hermes-motors/fengari/materials.org

* Supplied
+ [X] 1x 1P52FMI engine (including intake, carburetor, shifter, kickstarter, CDI)
+ [X] 1x 1P52FMI exhaust
+ [X] 2x 415H chain - 11.8872mm overall width, 4.75mm inner width
+ [X] 1x M8 Foot pegs
+ [X] 1x keyshaft 15mm (diameter) x 50mm (length)
+ [X] 1x key 5mm x 5mm x 35mm
+ [X] 2x 6902-2RS Bearing 15mm ID, 28mm OD, 7mm W
+ [X] 5x M8 threaded rod x 300mm (cut down to 180mm) (engine mount)
+ [X] 11x M8 nuts
+ [X] 15x M8 washers
+ [X] 1x M8 x 10mm (exhaust mount)
+ [X] 4x M6 x 35mm (sprocket)
+ [X] 4x M6 x 15mm (electrical enclosure)
+ [X] 6x M2 x 16mm (bearing retainer)
+ [X] 6x M2 nuts (bearing retainer)

* Machined
+ [X] 2x 3.175mm flat face mounts
+ [X] 1x 3.175mm support brace
+ [X] 2x 3.175mm jackshaft mount
+ [X] 4x 1.88mm jackshaft bearing retainer
+ [ ] 1x 3.175mm exhaust mount
+ [ ] 1x 1.88mm jackshaft bearing cap
+ [ ] 1x jackshaft sprocket
+ [ ] 1x engine sprocket
+ [X] 1x 4.75mm shift relocater
+ [ ] 1x 4.75mm chain tensioner

* Printed
+ [X] 1x electrical enclosure

* Spacers
15mm OD, 8mm ID

+ [X] 1x 5mm exhaust hanger spacer
+ [X] 1x 10mm engine mount offset spacer
+ [X] 5x 40.0mm jackshaft spacers
+ [X] 3x 31.0mm right side engine mount spacers
+ [X] 3x 12.5mm pre-jackshaft spacers
+ [X] 3x 56mm inner frame spacers
+ [X] 2x 15.5mm engine mount to jackshaft mount spacers

* Complete
+ [ ] Wiring Harness
