hermes-motors/fengari/dxf/jackshaft_mount_4.dxf

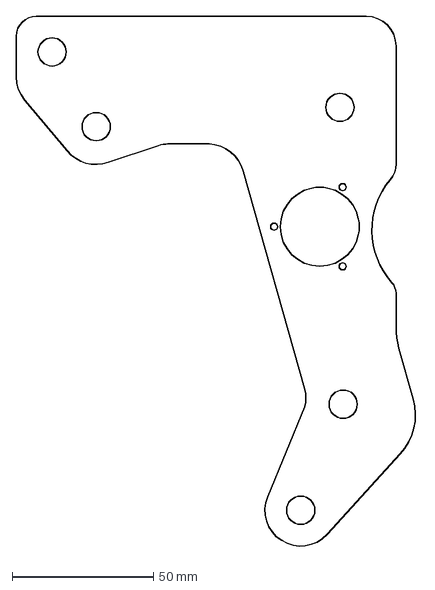
[picture p1: CAD file, 2023-04-24]
dxf/jackshaft_mount_4.dxf
142.5 x 189.0 mm
