hermes-motors/fengari/electric_enclosure.FCStd

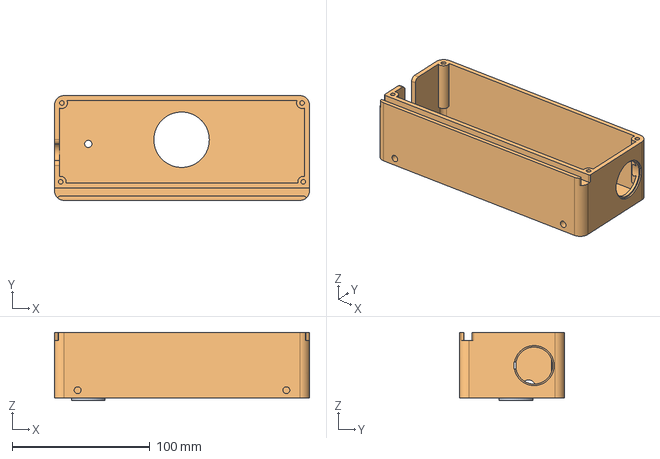
[picture p2: CAD file, 2026-04-15]
electric_enclosure.FCStd
185.0 x 76.0 x 49.5 mm
Spacer
Enclosure002
