hermes-motors/fengari/stl/shift_relocate-Extrude.stl

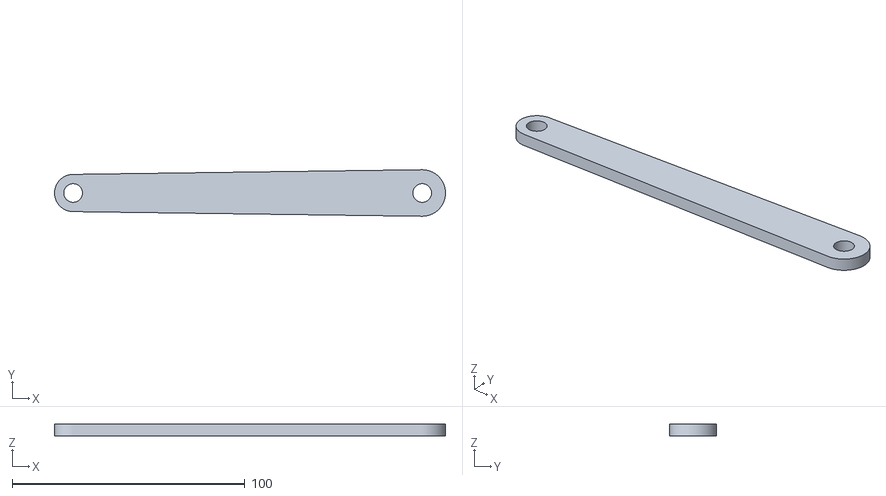
[picture p3: CAD file, 2023-12-20]
stl/shift_relocate-Extrude.stl
168.0 x 20.0 x 5.00
