hermes-motors/fengari/dxf/jackshaft_bearing_retainer.dxf

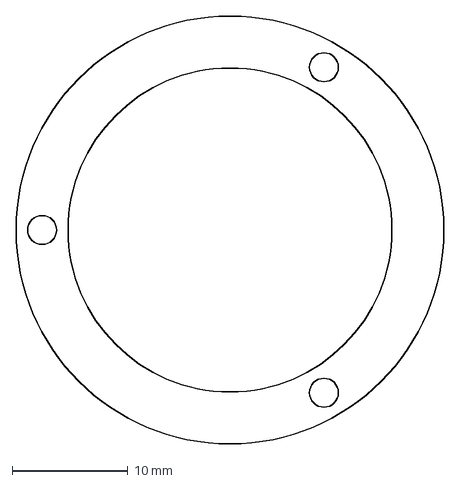
[picture p4: CAD file, 2023-04-24]
dxf/jackshaft_bearing_retainer.dxf
36.9 x 36.9 mm
