hermes-motors/fengari/engine_sprocket.FCStd

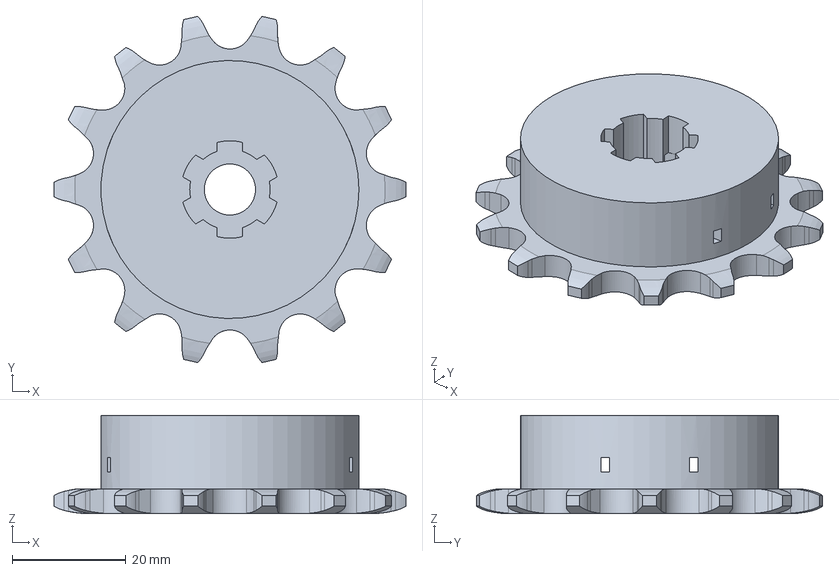
[picture p5: CAD file, 2026-04-10]
engine_sprocket.FCStd
61.9 x 60.9 x 17.3 mm
