hermes-motors/fengari/stl/jackshaft-Jackshaft Sprocket Spacer 2.stl

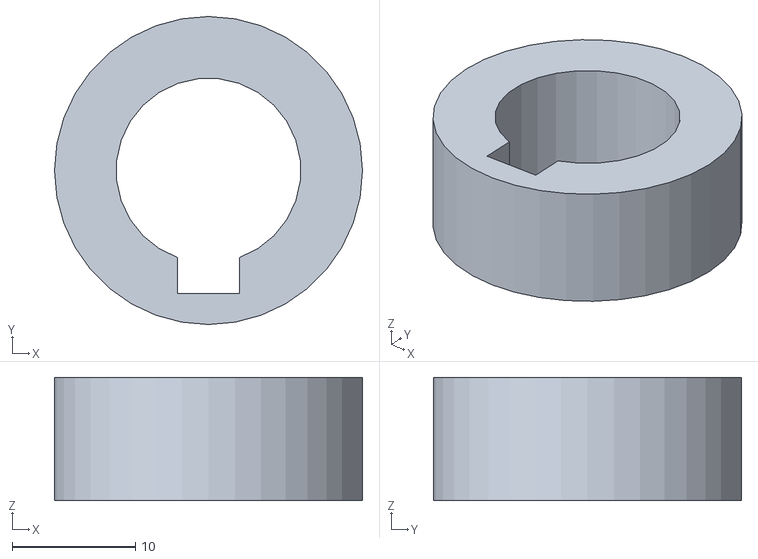
[picture p6: CAD file, 2023-05-31]
stl/jackshaft-Jackshaft Sprocket Spacer 2.stl
25.0 x 25.0 x 10.0
