hermes-motors/fengari/dxf/jackshaft_mount_1.dxf

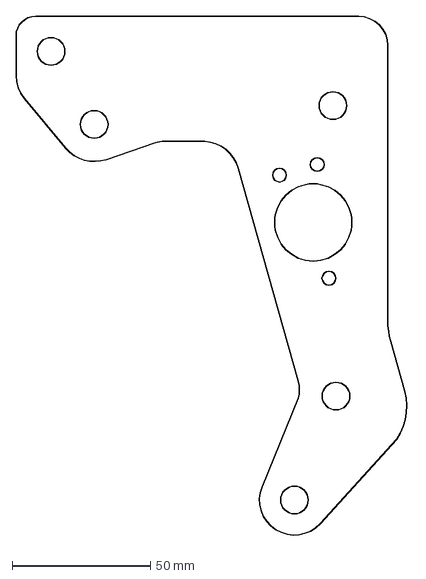
[picture p7: CAD file, 2023-02-12]
dxf/jackshaft_mount_1.dxf
142.5 x 189.0 mm
