hermes-motors/fengari/idler_sprocket.FCStd

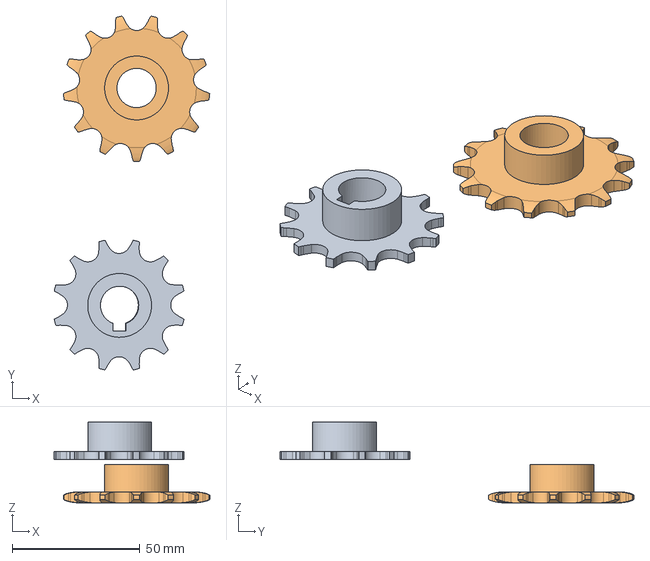
[picture p8: CAD file, 2026-03-31]
idler_sprocket.FCStd
60.9 x 138.6 x 31.6 mm
Flanged Sprocket 12t
Flanged Sprocket 13t
