hermes-motors/fengari/stl/jackshaft-Jackshaft Sprocket Spacer 0.stl

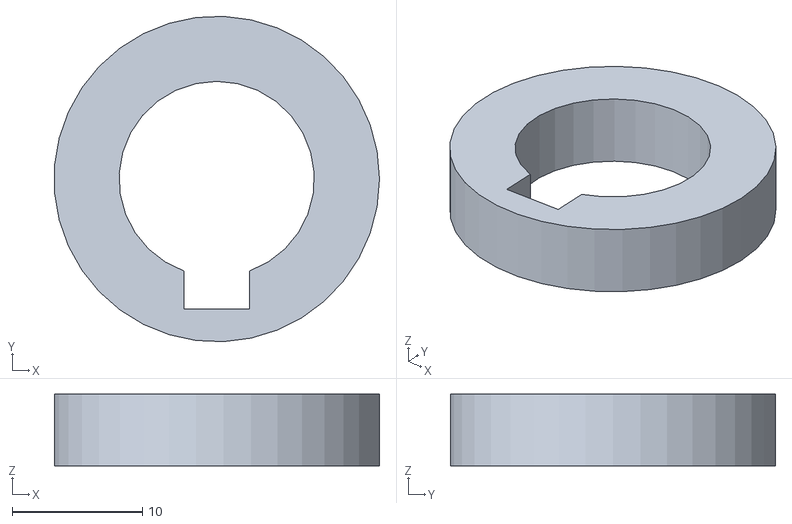
[picture p9: CAD file, 2023-05-31]
stl/jackshaft-Jackshaft Sprocket Spacer 0.stl
25.0 x 25.0 x 5.50
