hermes-motors/fengari/dxf/jackshaft_mount_0.dxf

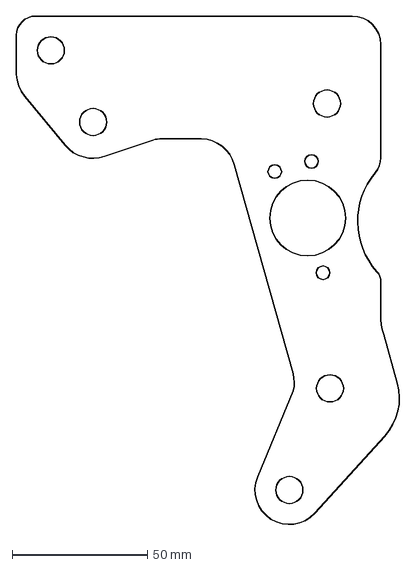
[picture p10: CAD file, 2023-02-12]
dxf/jackshaft_mount_0.dxf
142.5 x 189.0 mm
