hermes-motors/fengari/stl/jackshaft-Jackshaft Sprocket Spacer 1.stl

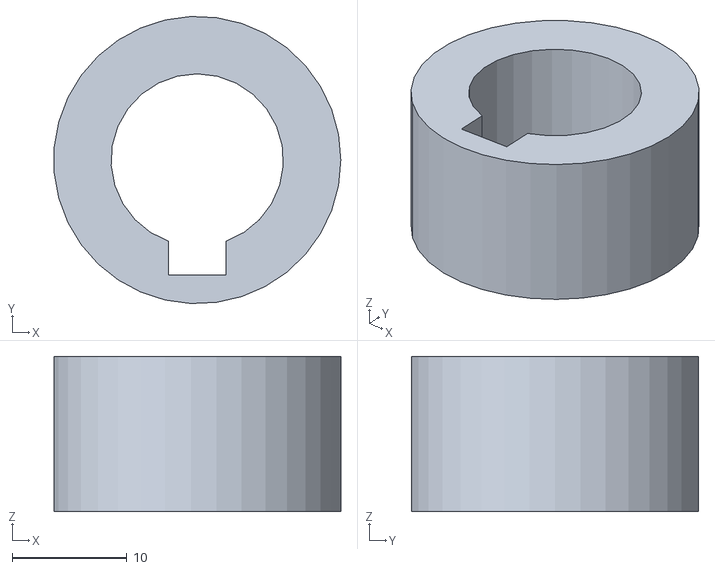
[picture p11: CAD file, 2023-05-31]
stl/jackshaft-Jackshaft Sprocket Spacer 1.stl
24.9 x 25.0 x 13.5
