hermes-motors/fengari/dxf/jackshaft_cover.dxf

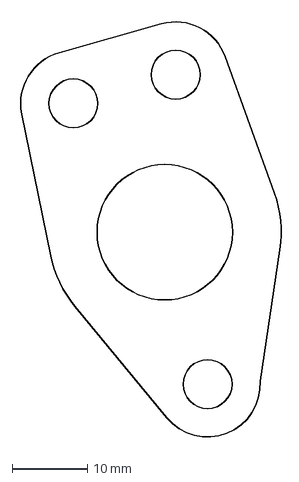
[picture p12: CAD file, 2023-02-12]
dxf/jackshaft_cover.dxf
35.4 x 56.5 mm
