hermes-motors/fengari/outer_engine_shaft_cover.FCStd

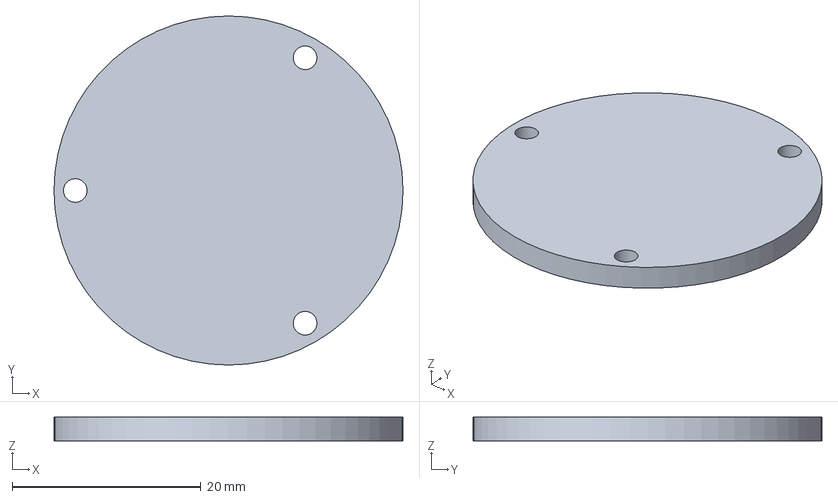
[picture p13: CAD file, 2026-03-25]
outer_engine_shaft_cover.FCStd
36.9 x 36.9 x 2.54 mm
