hermes-motors/fengari/stl/bevel_grinding_jig-Top Plate.stl

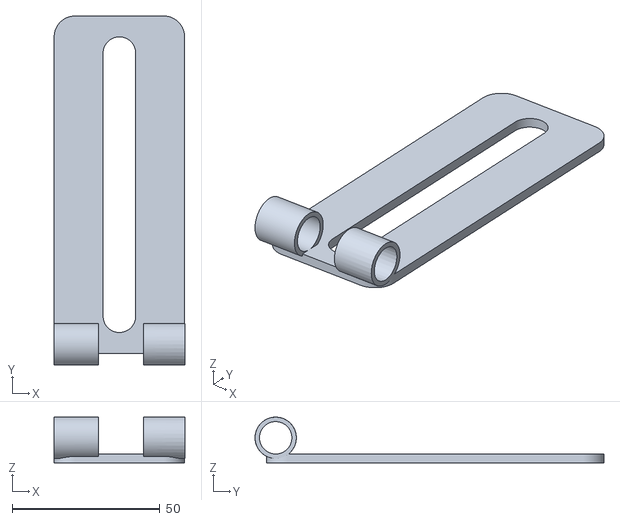
[picture p14: CAD file, 2023-05-10]
stl/bevel_grinding_jig-Top Plate.stl
44.2 x 118.1 x 15.5
