hermes-motors/fengari/dxf/frame_brace.dxf

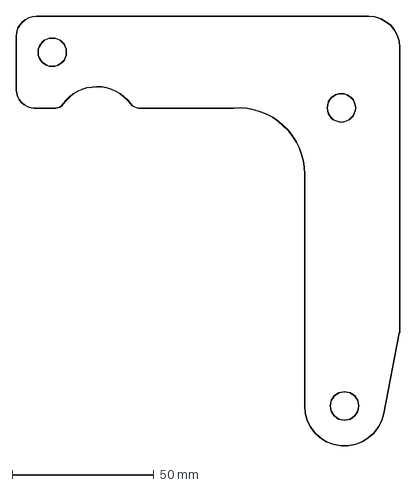
[picture p15: CAD file, 2023-01-17]
dxf/frame_brace.dxf
135.2 x 152.2 mm
