hermes-motors/fengari/fender_clip.FCStd

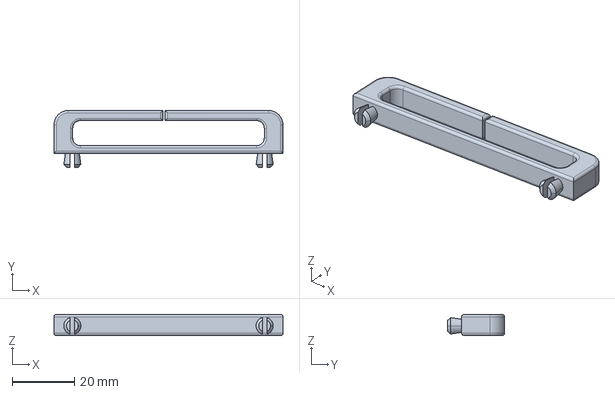
[picture p16: CAD file, 2026-03-15]
fender_clip.FCStd
73.3 x 18.2 x 6.75 mm
