hermes-motors/fengari/stl/bevel_grinding_jig-Bottom Plate.stl

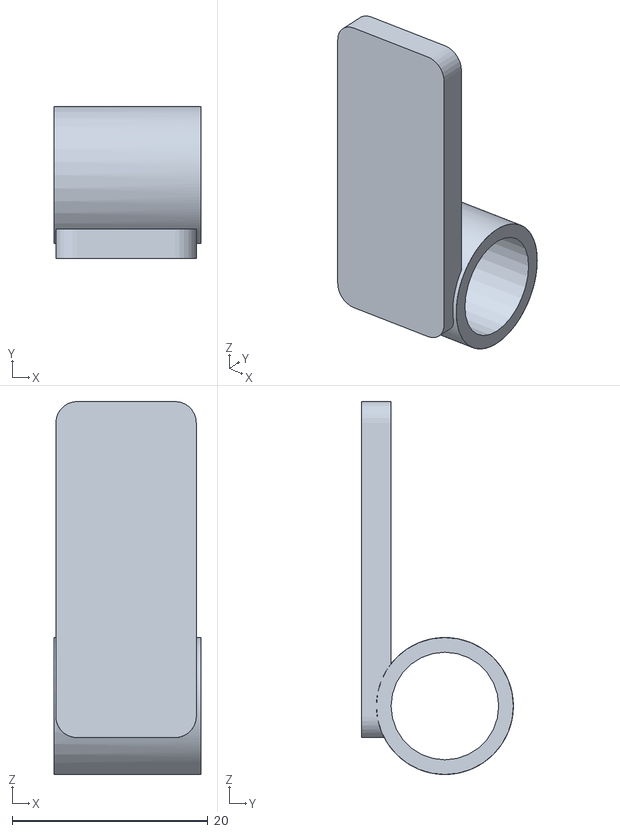
[picture p17: CAD file, 2023-05-10]
stl/bevel_grinding_jig-Bottom Plate.stl
15.0 x 15.5 x 38.1
