hermes-motors/fengari/dxf/exhaust_mount.dxf

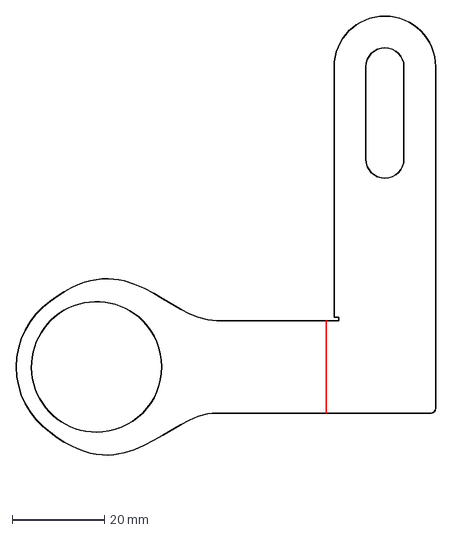
[picture p18: CAD file, 2023-01-17]
dxf/exhaust_mount.dxf
90.8 x 103.3 mm
