hermes-motors/fengari/intake_trumpet.FCStd

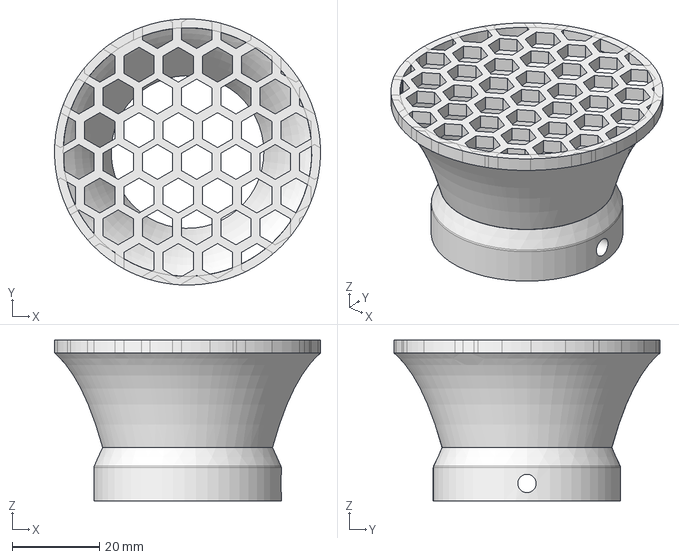
[picture p19: CAD file, 2023-06-19]
intake_trumpet.FCStd
61.0 x 61.0 x 36.9 mm
