hermes-motors/fengari/stl/bevel_grinding_jig-Adapter.stl

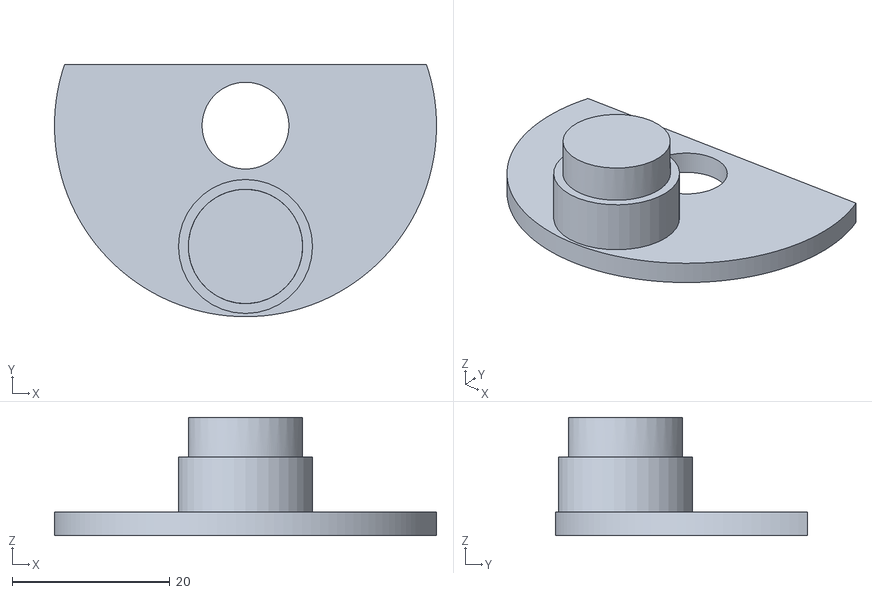
[picture p20: CAD file, 2023-05-10]
stl/bevel_grinding_jig-Adapter.stl
48.5 x 32.0 x 15.0
