hermes-motors/fengari/dxf/engine_mount_flat.dxf

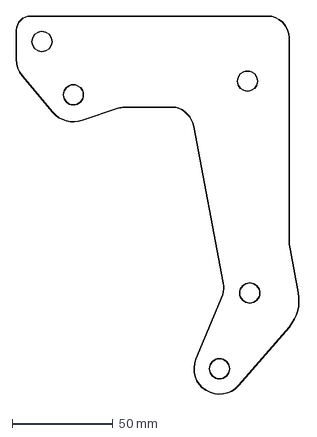
[picture p21: CAD file, 2023-01-17]
dxf/engine_mount_flat.dxf
141.0 x 189.0 mm
