hermes-motors/fengari/spacers.FCStd

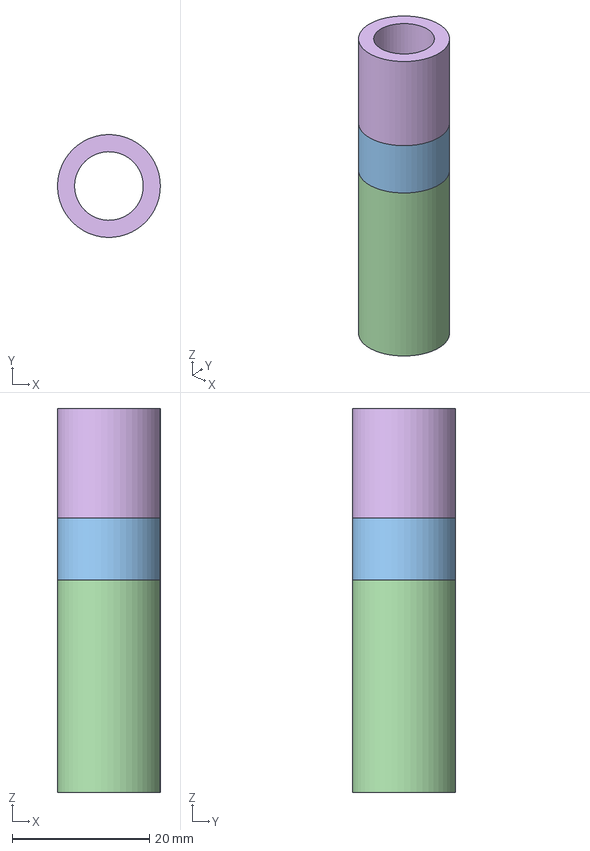
[picture p22: CAD file, 2023-05-04]
spacers.FCStd
15.0 x 15.0 x 56.0 mm
Exhaust Spacer
Engine Offset
Jackshaft Spacer
Engine Mount Spacer
Pre Jackshaft Spacer
Inner Frame Spacer
Engine Mount to Jackshaft Mount Spacer
