hermes-motors/fengari/stl/spacers-Jackshaft Spacer.stl

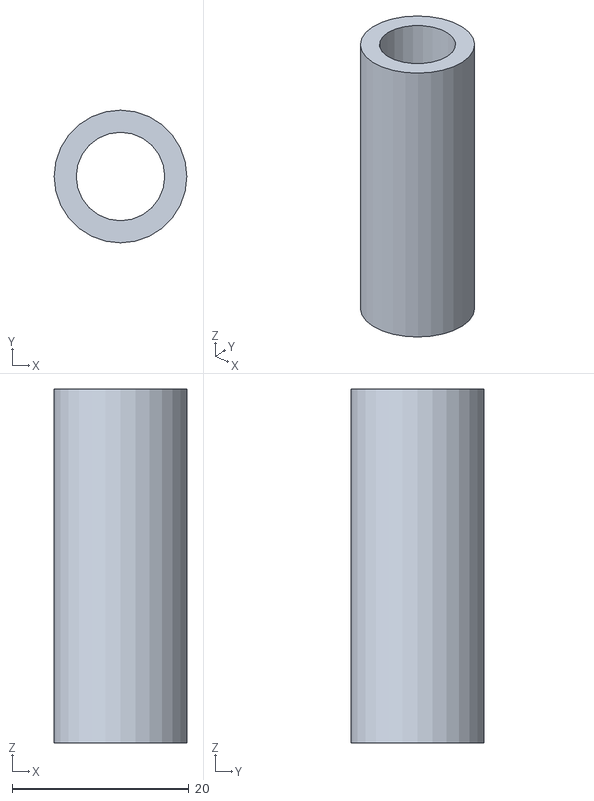
[picture p23: CAD file, 2023-05-04]
stl/spacers-Jackshaft Spacer.stl
15.0 x 15.0 x 40.0
