hermes-motors/fengari/dxf/jackshaft_mount.dxf

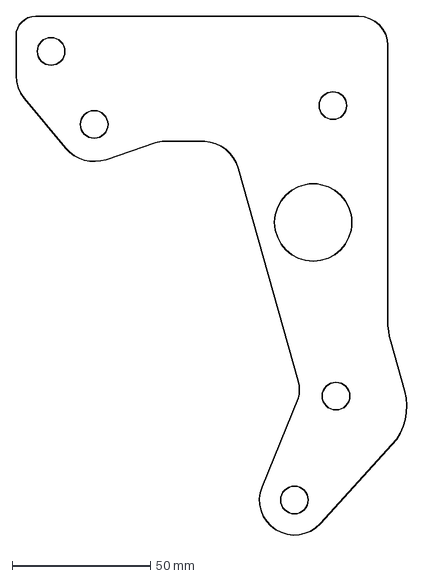
[picture p24: CAD file, 2023-01-17]
dxf/jackshaft_mount.dxf
142.5 x 189.0 mm
