hermes-motors/fengari/exhaust_mount_0.FCStd

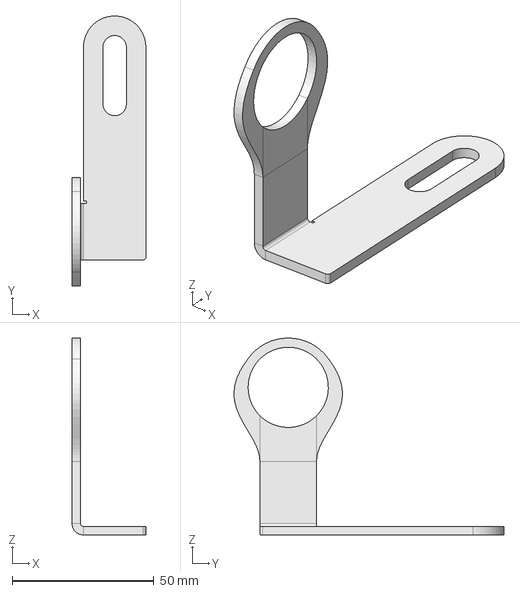
[picture p25: CAD file, 2023-01-13]
exhaust_mount_0.FCStd
26.0 x 95.1 x 69.4 mm
