hermes-motors/fengari/(list of files, cad)

Other CAD files:
shift_relocate.FCStd
dxf/shift_relocate.dxf
stl/electric_enclosure.stl
stl/intake_trumpet.stl
