hermes-motors/fengari/(commit log)

2023-01-13 Initial commit.
    [exhaust_mount_0.FCStd]
2023-01-17 dxf/*: add extracted drawings
    [engine_mount_flat.dxf, engine_sprocket.dxf, engine_sprocket_lock.dxf, engine_sprocket_spacer.dxf, engine_sprocket_threaded.dxf, exhaust_mount.dxf, foot_mount.dxf, frame_brace.dxf]
2023-01-17 materials.org: update dimensions
2023-01-19 materials.org: add wiring information
2023-01-21 materials.org: materials ordered!
2023-01-26 electric_enclosure: new revision, wider holes
2023-01-30 spacers.fcstd: add spacers with dimensions
    [spacers.FCStd]
2023-01-30 materials.org: add spacers
2023-01-30 electric_enclosure: Update electric enclosure to allow through bolt
2023-01-31 materials.org: add final spacer
2023-01-31 spacers.fcstd: add engine mount to jackshaft spacer
    [spacers.FCStd]
2023-01-31 materials.org: organize to make ordering consistent
2023-02-01 materials.org: inner frame spacers should be 56mm for easier mounting
    56.5 fits, but it is very tight
2023-02-01 spacers.fcstd: change inner spacer dimension to 56
    [spacers.FCStd]
2023-02-01 materials.org: increase pre-jackshaft spacers to clearance mount
    [spacers.FCStd]
2023-02-01 materials.org: all spacers created
2023-02-03 step_mount: create simplified step mount geometry
    [foot_mount.dxf]
2023-02-03 materials.org: remove spot welder from materials
    modified step mount doesn't require a spot welder
    can't use a miter saw to cut steel accurately
2023-02-04 materials.org: finalize dimensions of spacers
2023-02-04 materials.org: unmark parts that require design fixes
2023-02-12 jhackshaft_2: modify to deal with bump by pedal mount
2023-02-12 *.dxf: switch to new jackshaft mount design
    tighten tolerance to 27.985 for bearing press fit
    [jackshaft_cover.dxf, jackshaft_mount_0.dxf, jackshaft_mount_1.dxf]
2023-02-12 materials.org: update dimensions and parts
2023-02-12 materials.org: update with ordered parts
2023-02-12 materials.org: update dimensions to manufacturer specifications
2023-03-12 jackshaft_mount_0.dxf: try 27.965 ID for bearing press fit
    jackshaft_mount_3.dxf: 27.95 ID for bearing press fit
    [jackshaft_mount_3.dxf]
2023-04-21 Attempt jackshaft variant with bearing retainers.
    [jackshaft_bearing_retainer.dxf, jackshaft_mount_3.dxf, jackshaft_mount_4.dxf]
2023-04-21 materials.org: parts ordered.
2023-04-24 Update jackshaft bearing hole size to 2.5.
    This is for manufacturability.
    [jackshaft_bearing_retainer.dxf, jackshaft_mount_4.dxf]
2023-05-04 *: try inter-sprocket spacers to keep chains from hitting!
    [jackshaft-Jackshaft Sprocket Spacer.stl, spacers-Jackshaft Spacer.stl, spacers.FCStd]
2023-05-05 Offset interjackshaft sprocket spacers.
    [jackshaft-Jackshaft Sprocket Spacer 0.stl, jackshaft-Jackshaft Sprocket Spacer 1.stl, jackshaft-Jackshaft Sprocket Spacer 2.stl]
2023-05-10 bevel_grinding_jig: initial draft.
    this jig is designed to help cut a bevel on the sprocket gears to help
    them flow smoothly.
    [bevel_grinding_jig-Adapter.stl, bevel_grinding_jig-Bottom Plate.stl, bevel_grinding_jig-Top Plate.stl, bevel_grinding_jig.FCStd]
2023-05-11 materials.org: tweak jackshaft sprocket spacer sizes
    this makes the chain run smoother
2023-05-11 materials.org: sprockets purchased.
2023-05-14 materials.org: tweak jackshaft sprocket spacer sizes
    [jackshaft-Jackshaft Sprocket Spacer 1.stl, jackshaft-Jackshaft Sprocket Spacer 2.stl]
2023-05-15 materials.org: purchase electrical enclosure bolts
2023-05-15 materials.org: move jackshaft sprocket spacers to 3D printed sections
    these can be 3D printed, they do not need to be machined out of metal
2023-05-15 materials.org: note cutting down of main support rods.
2023-05-15 materials.org: formalize on 3.175mm jackshaft sprocket
    4.75mm is possible, but all other measurements in the document assume
    a 3.175mm width sprocket
    additionally, a 4.75mm sprocket will require grinding/bevel grinding
    in order to flow correctly
2023-05-15 materials.org: specify the length of the key
2023-05-15 materials.org: revise the length of the keyshaft
2023-05-15 materials.org: change jackshaft sprocket spacer to reflect current measurements.
2023-05-15 materials.org: remove sleeve bearing, it is unneeded.
2023-05-15 materials.org: group nuts/bolts together, provide context.
2023-05-15 materials.org: mark as purchased.
2023-05-15 materials.org: include exhaust mount bolt.
2023-05-23 materials.org: tweak jackshaft sprocket spacers
    plastic spacers of main frame mount were replaced with metal (not
    easily compressible), and thus all measurements for the jackshaft
    sprocket spacers must now be tweaked.
2023-05-31 Update jackshaft sprocket spacer STL files.
    [jackshaft-Jackshaft Sprocket Spacer 0.stl, jackshaft-Jackshaft Sprocket Spacer 1.stl, jackshaft-Jackshaft Sprocket Spacer 2.stl]
2023-05-31 intake_trumpet: first iteration.
    [intake_trumpet.FCStd, intake_trumpet.stl]
2023-06-19 Remove foot pedal mount, not needed.
    [foot_mount.dxf]
2023-06-19 Update intake_trumpet to finalized design.
    [intake_trumpet.FCStd, intake_trumpet.stl]
2023-06-19 materials.org: update to reflect latest changes.
2023-08-23 materials.org: Update.
2023-12-20 electric_enclosure: Update to include divot for frame clearance.
    [electric_enclosure.stl]
2023-12-20 shift_relocate: confirm design.
    [shift_relocate-Extrude.stl, shift_relocate.FCStd, shift_relocate.dxf]
2023-12-26 materials.org: Update to single sprocket design.
2026-02-28 Jackshaft cover initial revision
    [jackshaft_shaft_cover.FCStd]
2026-03-15 fender_clip: version one, none detent locking fasteners
    [fender_clip.FCStd]
2026-03-15 idler: Create idler sprocket
    [idler.FCStd]
2026-03-15 fender_clip: Update version to snap into fender
    [fender_clip.FCStd]
2026-03-25 Remove usage of jackshaft, it is now an outer engine mount
    [jackshaft_shaft_cover.FCStd, outer_engine_shaft_cover.FCStd]
2026-03-25 deleted: bevel_grinding_jig
    [bevel_grinding_jig.FCStd]
2026-03-26 Rename engine cog/idler to engine_sprocket and idler_sprocket
    [engine_cog.FCStd, engine_sprocket.FCStd, idler.FCStd, idler_sprocket.FCStd]
2026-03-28 materials.org: Update
2026-03-28 shift_relocate.FCStd: Update to latest FreeCAD
    [shift_relocate.FCStd]
2026-03-30 *_sprocket: Add bevel to faces
    [engine_sprocket.FCStd, idler_sprocket.FCStd]
2026-03-30 outer_engine_mount_tensioner: Create tensioner for chain
2026-03-31 Update sprocket/idler with convolute groove
    [engine_sprocket.FCStd, idler_sprocket.FCStd]
2026-04-07 engine_sprocket: Tweak dimensions, space out sprocket by 2mm
    [engine_sprocket.FCStd]
2026-04-10 engine_sprocket: Add bore hole for puller tool
    Adding a hole in the center of the sprocket allows it to be removed
    with a puller tool if necessary
    [engine_sprocket.FCStd]
2026-04-10 materials.org: Update materials list with project changes
2026-04-12 electric_enclosure: Modify cable inclusion hole
    [electric_enclosure.FCStd]
2026-04-12 dxf/*_sprocket*: Delete 2D Sprocket designs
    We must utilize a CNC service to machine 3D sprockets. 2D sprockets
    suffer from too many limitations.
    [engine_sprocket.dxf, engine_sprocket_lock.dxf, engine_sprocket_spacer.dxf, engine_sprocket_threaded.dxf, jackshaft_sprocket.dxf]
2026-04-12 electric_enclosure: Use M4 screws to hold cover
    [electric_enclosure.FCStd]
2026-04-12 electric_enclosure: Modify to support ignition key
    [electric_enclosure.FCStd]
2026-04-13 electric_enclosure: Decrease spacer to 2mm
    [electric_enclosure.FCStd]
2026-04-13 electric_enclosure: Increase wire input area, decrease spark plug hole size
    Move key mount down
    [electric_enclosure.FCStd]
2026-04-13 electric_enclosure: Tweak widths and positions of components
    [electric_enclosure.FCStd]
2026-04-15 electric_enclosure: Move wire entrance up
    [electric_enclosure.FCStd]
2026-04-15 electric_enclsoure: Increase height by 10mm
    [electric_enclosure.FCStd]
2026-04-16 electric_enclosure: Add threads to body
2026-04-17 electric_enclsure: Increase key cylinder inset
